About-Time-Technologies/RS232-Relay/hardware/RS232-Relay.step

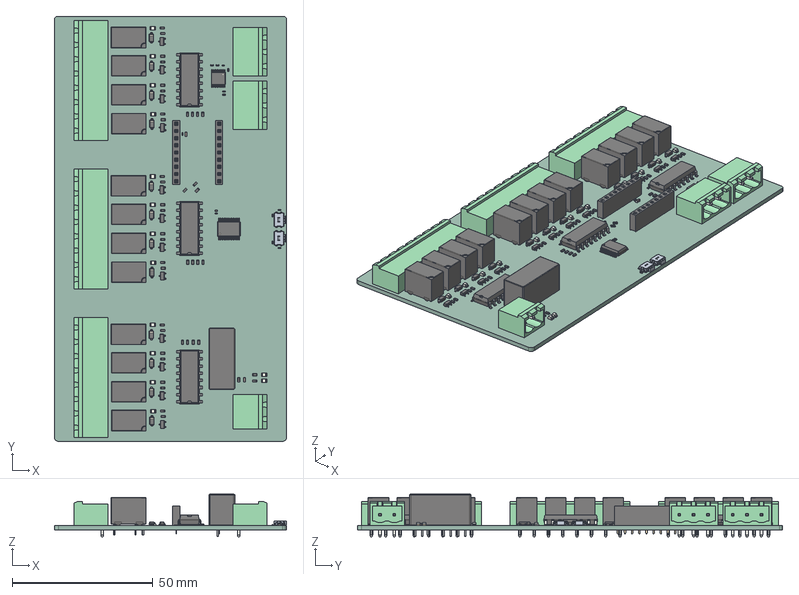
[picture p1: CAD file, 2024-09-11]
hardware/RS232-Relay.step
82.5 x 151.0 x 15.1 mm
R_0603_1608Metric x 41
SOT_23 x 12
LED_0805_2012Metric x 14
R_0402_1005Metric x 2
PinSocket_1x09_P254mm_Vertical x 2
Relay_SPDT_Omron_G5V-1 x 12
C_0402_1005Metric x 11
MSTBA_01x08_G_5_08mm x 3
MSTBA_01x02_G_5_08mm
SMDIP_16_W953mm x 3
D_SOD_123 x 12
TSSOP_16_44x5mm_P065mm
SSOP_24_53x82mm_P065mm
C_0603_1608Metric x 3
MSTBA_01x03_G_5_08mm x 2
Converter_DCDC_TRACO_TMR_xxxx_THT
RS232-Relay_PCB
