About-Time-Technologies/RS232-Relay/hardware/RS232-Relay.kicad_pcb

## KiCad design hardware/RS232-Relay.kicad_pcb (2024-10-06)

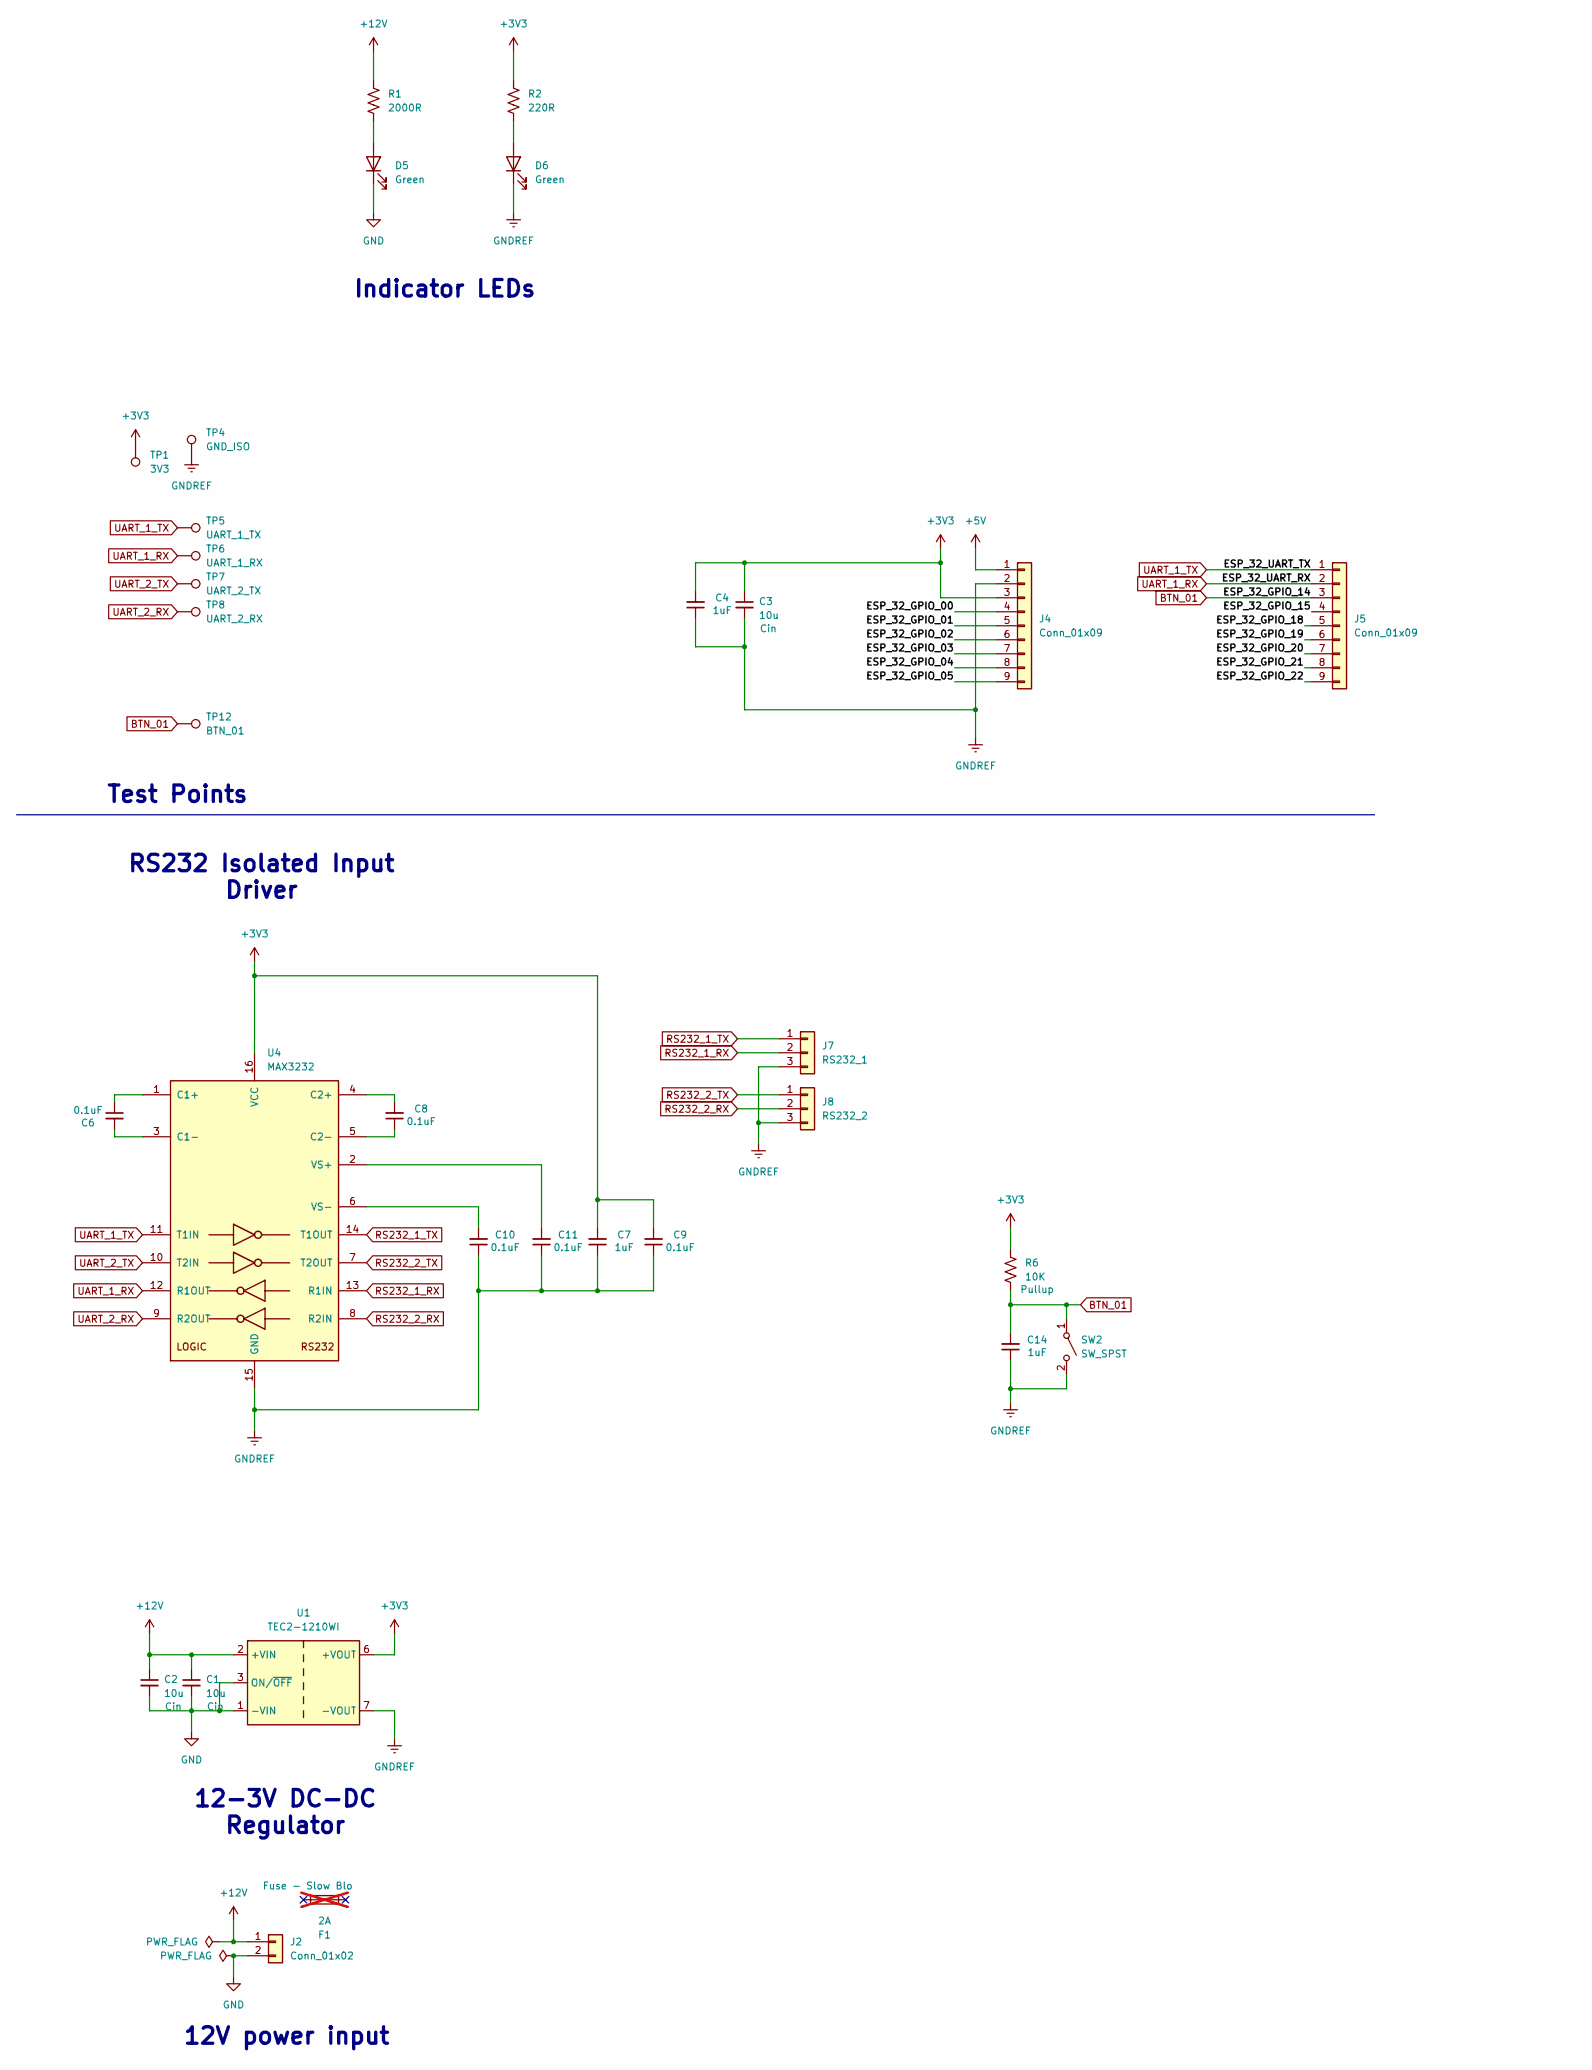
[picture p2: schematic RS232-Relay.kicad_sch, part in row 1, column 1]

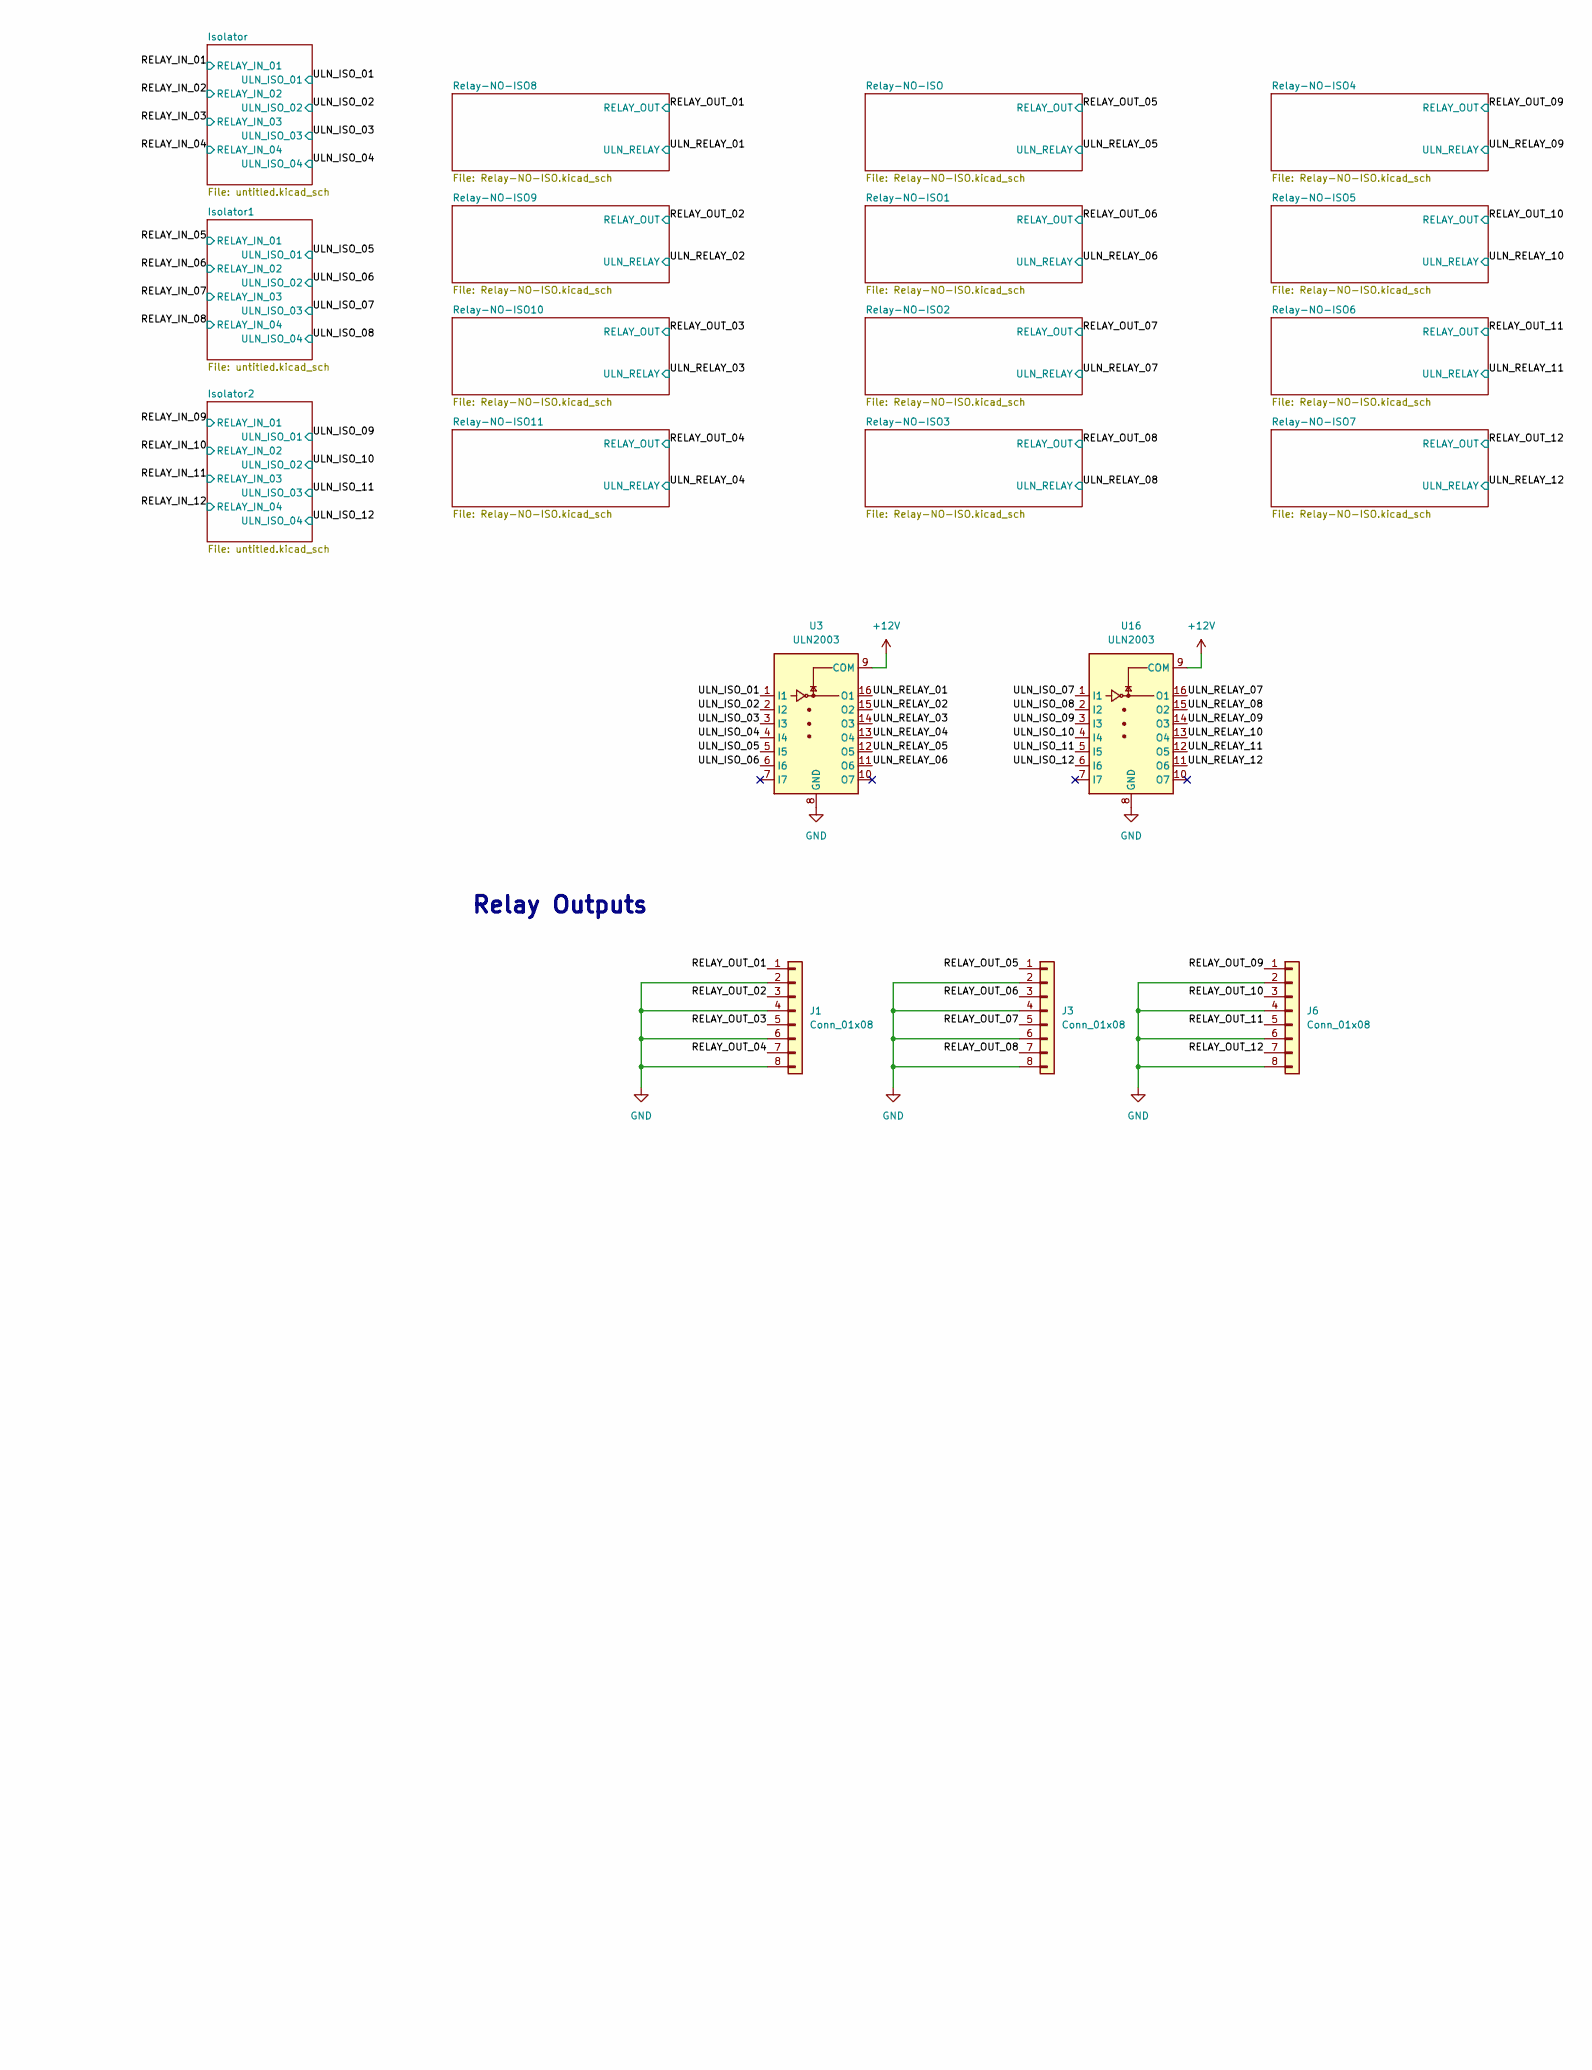
[picture p3: schematic RS232-Relay.kicad_sch, part in row 1, column 2]

Parts:
C1, C2, C3: 10u; C_0603_1608Metric; LCSC C19702
C4, C7, C14: 1uF; C_0402_1005Metric; LCSC C52923
C6, C8, C9, C10, C11: 0.1uF; C_0402_1005Metric; LCSC C307331
D5, D6: Green; LED_0805_2012Metric; LCSC C2297
F1: 2A; Fuseholder_Littelfuse_Nano2_154x; not fitted
J1, J3, J6: Conn_01x08; PhoenixContact_MSTBA_2,5_8-G-5,08_1x08_P5.08mm_Horizontal
J2: Conn_01x02; PhoenixContact_MSTBA_2,5_2-G-5,08_1x02_P5.08mm_Horizontal
J4, J5: Conn_01x09; PinSocket_1x09_P2.54mm_Vertical
J7: RS232_1; PhoenixContact_MSTBA_2,5_3-G-5,08_1x03_P5.08mm_Horizontal
J8: RS232_2; PhoenixContact_MSTBA_2,5_3-G-5,08_1x03_P5.08mm_Horizontal
R1: 2000R; R_0603_1608Metric; LCSC C22975
R2: 220R; R_0603_1608Metric; LCSC C22962
R6: 10K; R_0402_1005Metric; LCSC C25744
SW2: SW_SPST; SW_PUSH_1P1T_6x3.5mm_H4.3_APEM_MJTP1243
TP1: 3V3; TestPoint_Pad_D1.0mm
TP4: GND_ISO; TestPoint_Pad_D1.0mm
TP5: UART_1_TX; TestPoint_Pad_D1.0mm
TP6: UART_1_RX; TestPoint_Pad_D1.0mm
TP7: UART_2_TX; TestPoint_Pad_D1.0mm
TP8: UART_2_RX; TestPoint_Pad_D1.0mm
TP12: BTN_01; TestPoint_Pad_D1.0mm
U1: TEC2-1210WI; Converter_DCDC_TRACO_TMR-xxxx_THT
U3, U16: ULN2003; DIP-16_W7.62mm_SMDSocket_SmallPads; LCSC C2690547
U4: MAX3232; TSSOP-16_4.4x5mm_P0.65mm

Connections:
+3V3: C3.1, C4.2, C7.2, C9.2, J4.3, R2.1, R6.1, TP1.1, U1.6 (+VOUT), U4.16 (VCC)
+5V: J4.1
+12V: C1.1, C2.1, J2.1, R1.1, U1.2 (+VIN), U3.9 (COM), U16.9 (COM); also elsewhere on the board
/ESP_32_GPIO_00: J4.4
/ESP_32_GPIO_01: J4.5
/ESP_32_GPIO_02: J4.6
/ESP_32_GPIO_03: J4.7
/ESP_32_GPIO_04: J4.8
/ESP_32_GPIO_05: J4.9
/ESP_32_GPIO_15: J5.4
/ESP_32_GPIO_18: J5.5
/ESP_32_GPIO_19: J5.6
/ESP_32_GPIO_20: J5.7
/ESP_32_GPIO_21: J5.8
/ESP_32_GPIO_22: J5.9
/RELAY_OUT_01: J1.1; also elsewhere on the board
/RELAY_OUT_02: J1.3; also elsewhere on the board
/RELAY_OUT_03: J1.5; also elsewhere on the board
/RELAY_OUT_04: J1.7; also elsewhere on the board
/RELAY_OUT_05: J3.1; also elsewhere on the board
/RELAY_OUT_06: J3.3; also elsewhere on the board
/RELAY_OUT_07: J3.5; also elsewhere on the board
/RELAY_OUT_08: J3.7; also elsewhere on the board
/RELAY_OUT_09: J6.1; also elsewhere on the board
/RELAY_OUT_10: J6.3; also elsewhere on the board
/RELAY_OUT_11: J6.5; also elsewhere on the board
/RELAY_OUT_12: J6.7; also elsewhere on the board
/ULN_ISO_01: U3.1 (I1); also elsewhere on the board
/ULN_ISO_02: U3.2 (I2); also elsewhere on the board
/ULN_ISO_03: U3.3 (I3); also elsewhere on the board
/ULN_ISO_04: U3.4 (I4); also elsewhere on the board
/ULN_ISO_05: U3.5 (I5); also elsewhere on the board
/ULN_ISO_06: U3.6 (I6); also elsewhere on the board
/ULN_ISO_07: U16.1 (I1); also elsewhere on the board
/ULN_ISO_08: U16.2 (I2); also elsewhere on the board
/ULN_ISO_09: U16.3 (I3); also elsewhere on the board
/ULN_ISO_10: U16.4 (I4); also elsewhere on the board
/ULN_ISO_11: U16.5 (I5); also elsewhere on the board
/ULN_ISO_12: U16.6 (I6); also elsewhere on the board
/ULN_RELAY_01: U3.16 (O1); also elsewhere on the board
/ULN_RELAY_02: U3.15 (O2); also elsewhere on the board
/ULN_RELAY_03: U3.14 (O3); also elsewhere on the board
/ULN_RELAY_04: U3.13 (O4); also elsewhere on the board
/ULN_RELAY_05: U3.12 (O5); also elsewhere on the board
/ULN_RELAY_06: U3.11 (O6); also elsewhere on the board
/ULN_RELAY_07: U16.16 (O1); also elsewhere on the board
/ULN_RELAY_08: U16.15 (O2); also elsewhere on the board
/ULN_RELAY_09: U16.14 (O3); also elsewhere on the board
/ULN_RELAY_10: U16.13 (O4); also elsewhere on the board
/ULN_RELAY_11: U16.12 (O5); also elsewhere on the board
/ULN_RELAY_12: U16.11 (O6); also elsewhere on the board
BTN_01: C14.2, J5.3, R6.2, SW2.1 (A), TP12.1
GND: C1.2, C2.2, D5.1 (K), J1.2, J1.4, J1.6, J1.8, J2.2, J3.2, J3.4, J3.6, J3.8, J6.2, J6.4, J6.6, J6.8, U1.1 (-VIN), U1.3 (ON/~OFF), U3.8 (GND), U16.8 (GND); also elsewhere on the board
GNDREF: C3.2, C4.1, C7.1, C9.1, C10.1, C11.1, C14.1, D6.1 (K), J4.2, J7.3, J8.3, SW2.2 (B), TP4.1, U1.7 (-VOUT), U4.15 (GND); also elsewhere on the board
unnamed: D5.2 (A), R1.2
unnamed: D6.2 (A), R2.2
unnamed: C6.1, U4.1 (C1+)
unnamed: C6.2, U4.3 (C1-)
unnamed: C8.2, U4.4 (C2+)
unnamed: C8.1, U4.5 (C2-)
unnamed: C11.2, U4.2 (VS+)
unnamed: C10.2, U4.6 (VS-)
RS232_1_RX: J7.2, U4.13 (R1IN)
RS232_1_TX: J7.1, U4.14 (T1OUT)
RS232_2_RX: J8.2, U4.8 (R2IN)
RS232_2_TX: J8.1, U4.7 (T2OUT)
UART_1_RX: J5.2, TP6.1, U4.12 (R1OUT)
UART_1_TX: J5.1, TP5.1, U4.11 (T1IN)
UART_2_RX: TP8.1, U4.9 (R2OUT)
UART_2_TX: TP7.1, U4.10 (T2IN)

Notes on the sheet:
Relay Outputs
12-3V DC-DC Regulator
12V power input
RS232 Isolated Input Driver
Test Points
Indicator LEDs

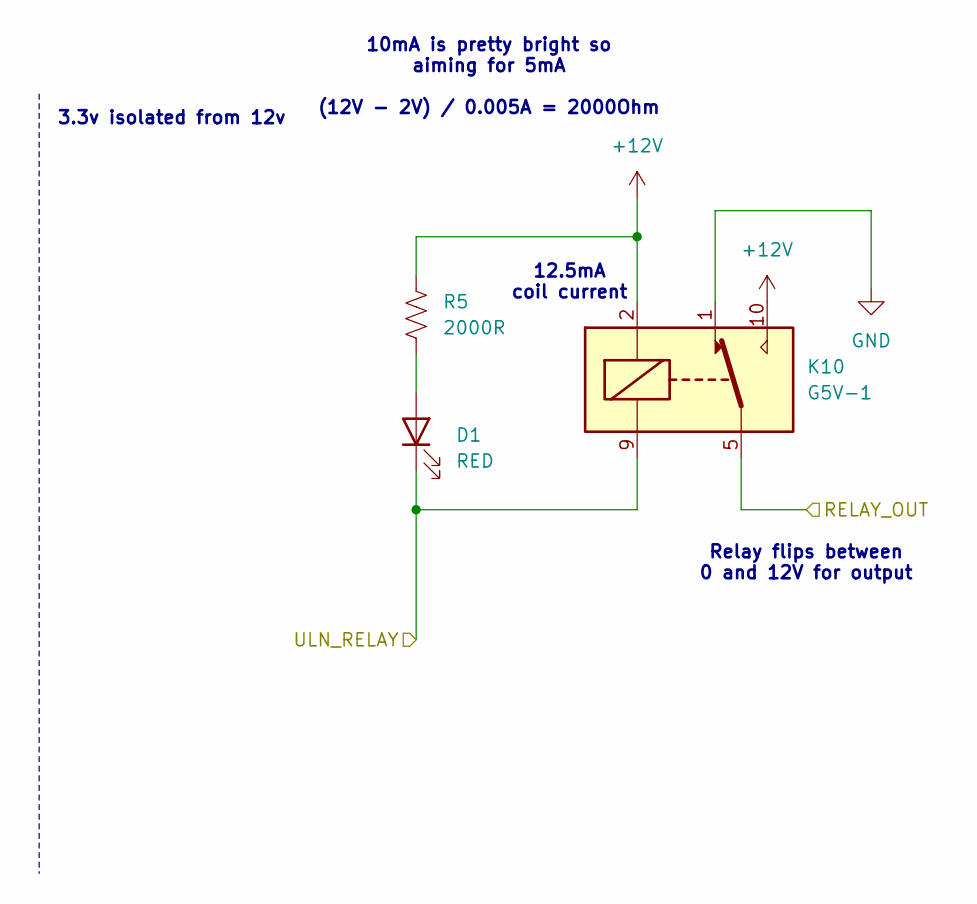
[picture p4: schematic Relay-NO-ISO.kicad_sch]

Parts:
D1: RED; LED_0805_2012Metric; LCSC C84256
K10: G5V-1; Relay_SPDT_Omron_G5V-1; LCSC C31113
R5: 2000R; R_0603_1608Metric; LCSC C22975

Connections:
+12V: K10.2, K10.10, R5.1; also elsewhere on the board
/RELAY_OUT_05: K10.5, K10.6; also elsewhere on the board
/ULN_RELAY_05: D1.1 (K), K10.9; also elsewhere on the board
GND: K10.1; also elsewhere on the board
unnamed: D1.2 (A), R5.2

Parts of its further copies:
D2, D3, D4, D7, D8, D9, D10, D11, D12, D13, D14: RED; LED_0805_2012Metric; LCSC C84256
K1, K2, K3, K4, K5, K6, K7, K8, K9, K11, K12: G5V-1; Relay_SPDT_Omron_G5V-1; LCSC C31113
R8, R10, R12, R14, R16, R18, R20, R22, R24, R26, R28: 2000R; R_0603_1608Metric; LCSC C22975

Connections of its further copies:
+12V: K1.2, K1.10, K2.2, K2.10, K3.2, K3.10, K4.2, K4.10, K5.2, K5.10, K6.2, K6.10, K7.2, K7.10, K8.2, K8.10, K9.2, K9.10, K11.2, K11.10, K12.2, K12.10, R8.1, R10.1, R12.1, R14.1, R16.1, R18.1, R20.1, R22.1, R24.1, R26.1, R28.1; also elsewhere on the board
/RELAY_OUT_01: K8.5, K8.6; also elsewhere on the board
/RELAY_OUT_02: K9.5, K9.6; also elsewhere on the board
/RELAY_OUT_03: K11.5, K11.6; also elsewhere on the board
/RELAY_OUT_04: K12.5, K12.6; also elsewhere on the board
/RELAY_OUT_06: K1.5, K1.6; also elsewhere on the board
/RELAY_OUT_07: K2.5, K2.6; also elsewhere on the board
/RELAY_OUT_08: K3.5, K3.6; also elsewhere on the board
/RELAY_OUT_09: K4.5, K4.6; also elsewhere on the board
/RELAY_OUT_10: K5.5, K5.6; also elsewhere on the board
/RELAY_OUT_11: K6.5, K6.6; also elsewhere on the board
/RELAY_OUT_12: K7.5, K7.6; also elsewhere on the board
/ULN_RELAY_01: D11.1 (K), K8.9; also elsewhere on the board
/ULN_RELAY_02: D12.1 (K), K9.9; also elsewhere on the board
/ULN_RELAY_03: D13.1 (K), K11.9; also elsewhere on the board
/ULN_RELAY_04: D14.1 (K), K12.9; also elsewhere on the board
/ULN_RELAY_06: D2.1 (K), K1.9; also elsewhere on the board
/ULN_RELAY_07: D3.1 (K), K2.9; also elsewhere on the board
/ULN_RELAY_08: D4.1 (K), K3.9; also elsewhere on the board
/ULN_RELAY_09: D7.1 (K), K4.9; also elsewhere on the board
/ULN_RELAY_10: D8.1 (K), K5.9; also elsewhere on the board
/ULN_RELAY_11: D9.1 (K), K6.9; also elsewhere on the board
/ULN_RELAY_12: D10.1 (K), K7.9; also elsewhere on the board
GND: K1.1, K2.1, K3.1, K4.1, K5.1, K6.1, K7.1, K8.1, K9.1, K11.1, K12.1; also elsewhere on the board
unnamed: D2.2 (A), R8.2
unnamed: D3.2 (A), R10.2
unnamed: D4.2 (A), R12.2
unnamed: D7.2 (A), R14.2
unnamed: D8.2 (A), R16.2
unnamed: D9.2 (A), R18.2
unnamed: D10.2 (A), R20.2
unnamed: D11.2 (A), R22.2
unnamed: D12.2 (A), R24.2
unnamed: D13.2 (A), R26.2
unnamed: D14.2 (A), R28.2

Notes on the sheet:
12.5mA coil current
3.3v isolated from 12v
Relay flips between 0 and 12V for output
10mA is pretty bright so aiming for 5mA (12V - 2V) / 0.005A = 2000Ohm

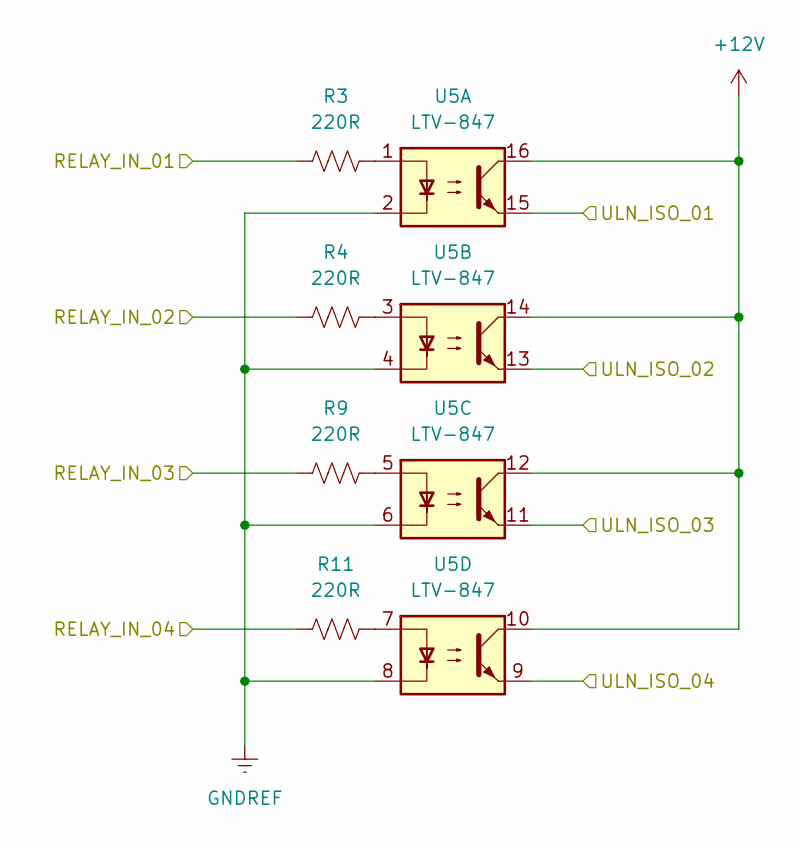
[picture p5: schematic untitled.kicad_sch]

Parts:
R3, R4, R9, R11: 220R; R_0603_1608Metric; LCSC C22962
U5: LTV-847; DIP-16_W7.62mm_SMDSocket_SmallPads

Connections:
+12V: U5.10, U5.12, U5.14, U5.16; also elsewhere on the board
/RELAY_IN_01: R3.1
/RELAY_IN_02: R4.1
/RELAY_IN_03: R9.1
/RELAY_IN_04: R11.1
/ULN_ISO_01: U5.15; also elsewhere on the board
/ULN_ISO_02: U5.13; also elsewhere on the board
/ULN_ISO_03: U5.11; also elsewhere on the board
/ULN_ISO_04: U5.9; also elsewhere on the board
GNDREF: U5.2, U5.4, U5.6, U5.8; also elsewhere on the board
unnamed: R3.2, U5.1
unnamed: R4.2, U5.3
unnamed: R9.2, U5.5
unnamed: R11.2, U5.7

Parts of its further copies:
R7, R13, R15, R17, R19, R21, R23, R25: 220R; R_0603_1608Metric; LCSC C22962
U2, U6: LTV-847; DIP-16_W7.62mm_SMDSocket_SmallPads

Connections of its further copies:
+12V: U2.10, U2.12, U2.14, U2.16, U6.10, U6.12, U6.14, U6.16; also elsewhere on the board
/RELAY_IN_05: R7.1
/RELAY_IN_06: R13.1
/RELAY_IN_07: R15.1
/RELAY_IN_08: R17.1
/RELAY_IN_09: R19.1
/RELAY_IN_10: R21.1
/RELAY_IN_11: R23.1
/RELAY_IN_12: R25.1
/ULN_ISO_05: U2.15; also elsewhere on the board
/ULN_ISO_06: U2.13; also elsewhere on the board
/ULN_ISO_07: U2.11; also elsewhere on the board
/ULN_ISO_08: U2.9; also elsewhere on the board
/ULN_ISO_09: U6.15; also elsewhere on the board
/ULN_ISO_10: U6.13; also elsewhere on the board
/ULN_ISO_11: U6.11; also elsewhere on the board
/ULN_ISO_12: U6.9; also elsewhere on the board
GNDREF: U2.2, U2.4, U2.6, U2.8, U6.2, U6.4, U6.6, U6.8; also elsewhere on the board
unnamed: R7.2, U2.1
unnamed: R13.2, U2.3
unnamed: R15.2, U2.5
unnamed: R17.2, U2.7
unnamed: R19.2, U6.1
unnamed: R21.2, U6.3
unnamed: R23.2, U6.5
unnamed: R25.2, U6.7

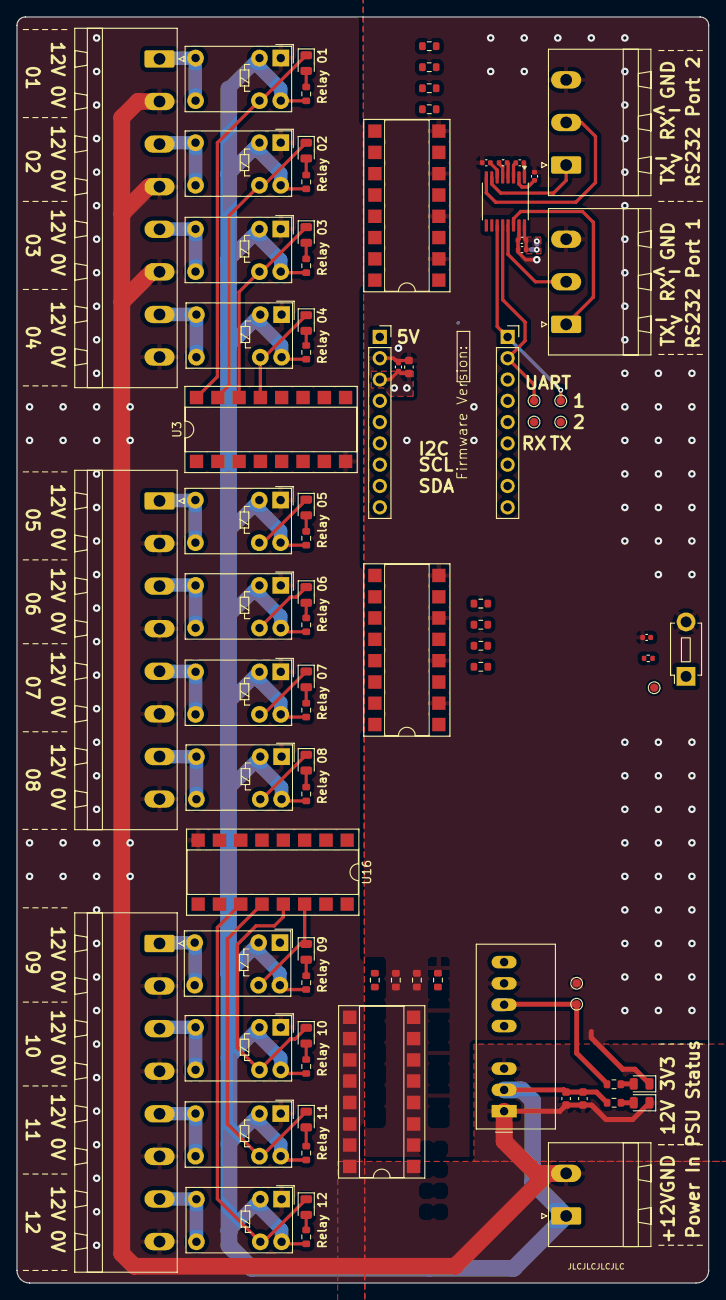
[picture p6: board RS232-Relay.kicad_pcb from above]

Board: 2 copper layers, 82.5 x 151.0 mm, 87 parts (0 on the bottom side), 81 nets.
