About-Time-Technologies/RS232-Relay/(commit log)

2024-08-26 Relay layout
    [RS232-Relay.kicad_pcb, RS232-Relay.kicad_sch, RS232-Relay.step]
2024-08-27 Including ESP32
    [RS232-Relay.kicad_sch]
2024-08-28 Adding RS232
    [RS232-Relay.kicad_pcb, RS232-Relay.kicad_sch]
2024-09-01 Basic schematic fully complete
    [RS232-Relay.kicad_pcb, RS232-Relay.kicad_sch, RS232-Relay.step]
2024-09-01 Fixing pin headers
    [RS232-Relay.kicad_pcb, RS232-Relay.kicad_sch]
2024-09-01 Schematic complete
    [RS232-Relay.kicad_pcb, RS232-Relay.kicad_sch, RelayModule.kicad_sch]
2024-09-01 Pre-template layouts
    [RS232-Relay.kicad_pcb, RS232-Relay.kicad_sch, RelayModule.kicad_sch]
2024-09-01 1x Layout Complete
    [RS232-Relay.kicad_pcb, Relay-NO-ISO.kicad_sch, RelayModule.kicad_sch]
2024-09-01 Routing Complete (vias next)
    [RS232-Relay.kicad_pcb, RS232-Relay.kicad_sch, RS232-Relay.step, Relay-NO-ISO.kicad_sch, RelayModule.kicad_sch]
2024-09-02 Initial fabrication samples
    [RS232-Relay.kicad_pcb]
2024-09-02 Port labels
    [RS232-Relay.kicad_pcb]
2024-09-02 Hide silkscreen designators
    [RS232-Relay.kicad_pcb]
2024-09-03 Silkscreen finished and vias added
    [RS232-Relay.kicad_pcb, RS232-Relay.step]
2024-09-03 Switching to drain rather than source
    [RS232-Relay.kicad_pcb, Relay-NO-ISO.kicad_sch]
2024-09-10 Figuring out the relay NC/NO connections
    [RS232-Relay.kicad_pcb, RS232-Relay.kicad_sch, Relay-NO-ISO.kicad_sch]
2024-09-10 Figured out a solution, now for implementation
    [RS232-Relay.kicad_pcb, RS232-Relay.kicad_sch, Relay-NO-ISO.kicad_sch]
2024-09-10 Solution implemented
    [RS232-Relay.kicad_pcb]
2024-09-10 50Ohm -> 51Ohm resistor on LED
    [RS232-Relay.kicad_sch]
2024-09-11 Production v1
    [RS232-Relay.kicad_pcb, RS232-Relay.kicad_sch, RS232-Relay.step, Relay-NO-ISO.kicad_sch, RelayModule.kicad_sch]
2024-09-13 PCB 3D Model for Blender testing
2024-09-14 Initial UART gambit
2024-09-27 Reverting to a really simple codebase
    [RS232-Relay.c, main.c]
2024-09-27 Transitioning to more robust circuit
    [RS232-Relay.kicad_pcb, RS232-Relay.kicad_sch, Relay-NO-ISO.kicad_sch, RelayModule.kicad_sch]
2024-10-06 It could work but it's too big
    [RS232-Relay.kicad_pcb, RS232-Relay.kicad_sch, Relay-NO-ISO.kicad_sch, RelayModule.kicad_sch]
2024-10-06 Schematic ready
    [RS232-Relay.kicad_pcb, RS232-Relay.kicad_sch, Relay-NO-ISO.kicad_sch, untitled.kicad_sch]
2024-10-10 Blinking LED
2024-10-26 UART configuration
2025-03-02 Add relay query commands to each request
